nasrudin2468/free-motion/Notes/interface pinning.png

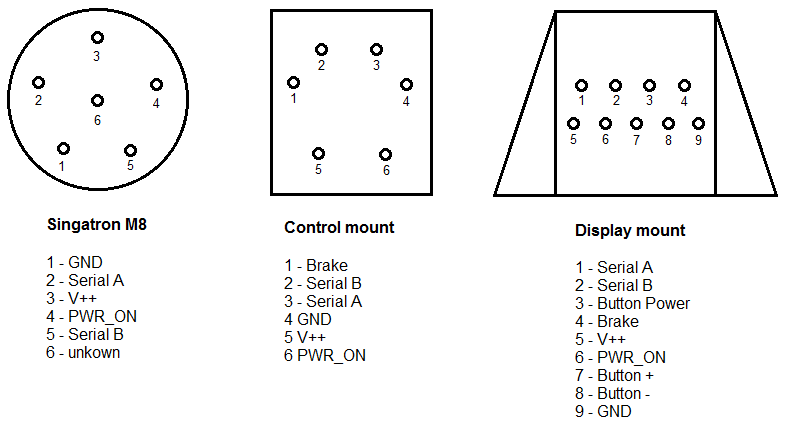
Notes/interface pinning.png
