nasrudin2468/free-motion/Notes/WD BH-EVO Controller to display 2017-04-20-1.png

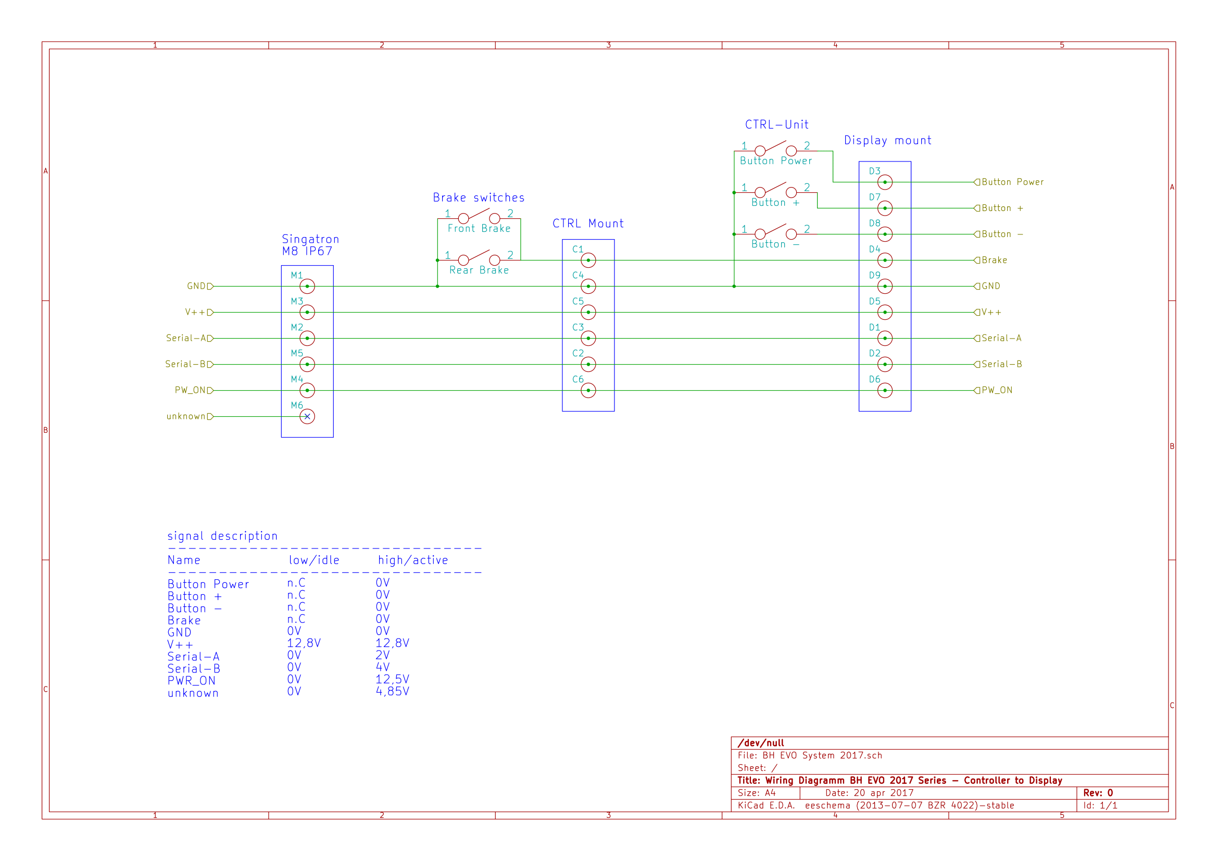
Notes/WD BH-EVO Controller to display 2017-04-20-1.png
