nasrudin2468/free-motion/PCB/REV 0.1/Documentation/3d_bot.png

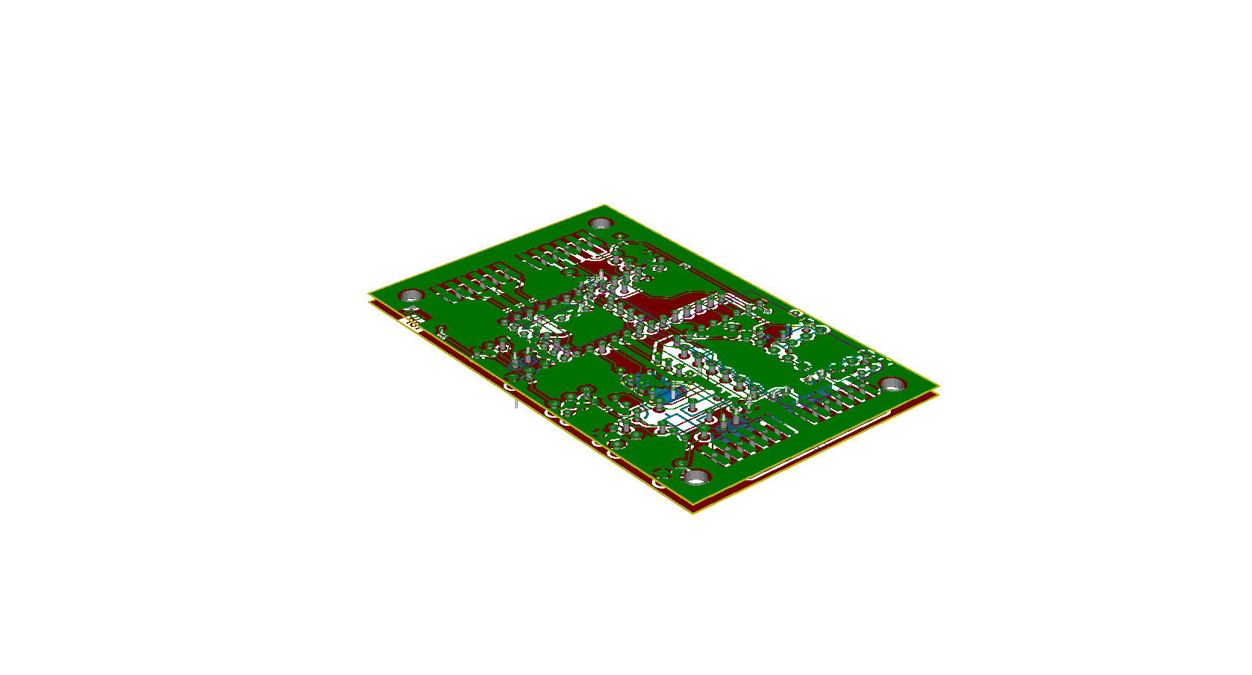
PCB/REV 0.1/Documentation/3d_bot.png
