nasrudin2468/free-motion/PCB/REV 0.1/Documentation/partlist - development - all parts.ods

ID | INDEX | count | Comment | part name | Mouser Ordner Number | Ext. Supplier | Ext. Order Number | Price per part (€) | Price (€)
1 | U1 | 1 | Teensy build: leave out if you don't need smartphone connection | BLUEFR_LE_UART_FR_BLE | 485-2479 |  |  | 14,88 | 14,88
2 | Q2 | 1 |  | LP0701N3-G | 689-LP0701N3-G |  |  | 1,4 | 1,4
3 | R3,R15 | 2 |  | 100R | MFR-25FRF52-100R |  |  | 0,085 | 0,17
4 | R13,R16,R4,R7,R9,R2,R6 | 7 |  | 1K | MFR-25FRF52-1K |  |  | 0,085 | 0,595
5 | R17 | 1 |  | 1K1 | MFR-25FRF52-1K1 |  |  | 0,085 | 0,085
6 | R8 | 1 |  | 470R | MFR-25FRF52-470R |  |  | 0,085 | 0,085
7 | R5,R11,R12 | 3 |  | 2K | MFR-25FRF52-2K |  |  | 0,085 | 0,255
8 | R10,R14 | 2 |  | 3K9 | MFR-25FRF52-3K9 |  |  | 0,085 | 0,17
9 | R1 | 1 |  | 6K8 | MFR-25FRF52-6K8 |  |  | 0,085 | 0,085
10 | K1 | 1 | Use spare from position 23. not needed for Teensy build | header 3pin | - |  |  | 0 | 0
11 | SP1 | 1 | Teensy build: leave out if you don't need acoustic feedback | CPE-165 | 490-CPE-165 |  |  | 1,01 | 1,01
12 | JP2,JP1 | 2 | Use spare from position 23 or short with solder. Must not be shorted for Teensy build. | jumper wire / header 2pin | - |  |  | 0 | 0
13 | D1 | 1 | Can be a 5V Zener, too | Std Diode / Zener 5V | TZX5V1B-TAP |  |  | 0,17 | 0,17
14 | D5,D4,D2,D3,D6 | 5 |  | ZENER 5V | TZX5V1B-TAP |  |  | 0,17 | 0,85
15 | C2,C3,C1 | 3 |  | 1uF | C333C105K5R5TA |  |  | 0,377 | 1,131
16 | Q5,Q3,Q1 | 3 |  | BC547 | 512-BC547BTA |  |  | 0,179 | 0,537
17 | Q4 | 1 |  | BC557 | 512-BC557BTA |  |  | 0,196 | 0,196
18 | P1,P2,P3,P4 | 4 | recommended but soldering cables directly on PCB is possible, too | PHOENIX1989780 | 651-1989780 |  |  | 0,655 | 2,62
19 | U2 | 1 | Teensy build: leave out if you don't need terrain based motorcontrol | SEN-13762 | 474-SEN-13762 |  |  | 12,71 | 12,71
20 | U3 | 1 |  | 78L05 | 926-LM78L05ACZ/NOPB |  |  | 0,51 | 0,51
21 | U4 | 1 |  | TEENSY_3.2 | 474-DEV-13736 |  |  | 19,87 | 19,87
22 | Outl | 1 |  | EuroBoard 80mmX50mm | - | oshpark.com |  | 5 | 5
23 | - | 2 | Use for all modules | Header | M20-9992545 |  |  | 0,731 | 1,462
24 | - | 1 | Bus-connector external female 6 pol | Phoenix 1522192 | 651-1522192 |  |  | 19,96 | 19,96
25 | - | 1 | Bus-connector external male 6 pol | Phoenix 1522095 | 651-1522095 |  |  | 17,33 | 17,33
26 | - | 1 | Bus-connector internal male 6 pol - can replace pos.23 for BH2017 series | 06T-JWPF-VSLE-D | - | rs-online.com | 820-1282 | 22,66 | 22,66
27 | - | 1 | Bus-connector internal female 6 pol - can replace pos.24 for BH2017 series | 06R-JWPF-VSLE-D | - | rs-online.com | 820-1289 | 14,43 | 14,43
28 | - | 1 | Crimp Contacts male for pos.26 | 01SWPTSWPT-24L-150 | - | rs-online.com | 820-1298 | 5,91 | 5,91
29 | - | 1 | Crimp Contacts female for pos.27 | 01SWPRSWPR-24L-150 | - | rs-online.com | 820-1286 | 5,91 | 5,91
30 | - | 1 | leave out if you don't need automatic light switch | SFH 3310 | 720-SFH3310 |  |  | 0,774 | 0,774
31 | - | 1 |  | Enclosure | 546-1591XXBSBK |  |  | 5,28 | 5,28
32 |  | 1 |  | jumper wire | 932-MIKROE-511 |  |  | 2,55 | 2,55
33 |  | 1 |  | CH340G USB to Serial (TTL) Module/Adapter | 713-317990026 |  |  | 1,66 | 1,66
 |  |  |  |  |  |  |  |  | 160,255
