nasrudin2468/free-motion/Notes/protocol analysis 2017-08-06.ods

Sheet: COM33_2017-05-01 HEX
 |  |  |  |  |  |  |  |  |  |  |  |  |  | Comments COM 33 (Serial A) begin Log
0 | FD | 7F | 0F |  |  |  |  |  |  |  |  |  |  | unknown (probably false reading due switching condition)
40 | 30 | 31 | 50 | 35 | 39 | 35 | 44 | 0D
40 | 30 | 31 | 50 | 35 | 39 | 35 | 44 | 0D
40 | 30 | 31 | 43 | 30 | 32 | 30 | 30 | 30 | 30 | 30 | 37 | 30 | 0D
40 | 30 | 31 | 43 | 30 | 32 | 30 | 30 | 30 | 30 | 30 | 37 | 30 | 0D
40 | 30 | 31 | 43 | 30 | 32 | 30 | 30 | 30 | 30 | 30 | 37 | 30 | 0D
40 | 30 | 31 | 43 | 30 | 32 | 30 | 30 | 30 | 30 | 30 | 37 | 30 | 0D
40 | 30 | 31 | 43 | 30 | 32 | 30 | 30 | 30 | 30 | 30 | 37 | 30 | 0D
40 | 30 | 31 | 43 | 30 | 32 | 30 | 30 | 30 | 30 | 30 | 37 | 30 | 0D
40 | 30 | 31 | 43 | 30 | 32 | 30 | 30 | 30 | 30 | 30 | 37 | 30 | 0D
40 | 30 | 31 | 43 | 30 | 32 | 30 | 30 | 30 | 30 | 30 | 37 | 30 | 0D
40 | 30 | 31 | 43 | 30 | 32 | 30 | 30 | 30 | 30 | 30 | 37 | 30 | 0D
40 | 30 | 31 | 43 | 30 | 32 | 30 | 30 | 30 | 30 | 30 | 37 | 30 | 0D
40 | 30 | 31 | 43 | 30 | 32 | 30 | 30 | 30 | 30 | 30 | 37 | 30 | 0D
40 | 30 | 31 | 42 | 4F | 46 | 46 | 30 | 30 | 30 | 30 | 30 | 43 | 0D
40 | 30 | 31 | 42 | 4F | 46 | 46 | 30 | 30 | 30 | 30 | 30 | 43 | 0D
0 | 8D | 46 | 46 | FA |  |  |  |  |  |  |  |  |  | unknown (probably false reading due switching condition)
40 | 30 | 31 | 50 | 35 | 39 | 35 | 44 | 0D |  |  |  |  |  | Lights on / off
40 | 30 | 31 | 50 | 35 | 39 | 35 | 44 | 0D
40 | 30 | 31 | 43 | 30 | 32 | 30 | 30 | 30 | 30 | 30 | 37 | 30 | 0D
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
40 | 30 | 31 | 43 | 30 | 30 | 30 | 30 | 30 | 30 | 30 | 37 | 32 | 0D
40 | 30 | 31 | 43 | 30 | 30 | 30 | 30 | 30 | 30 | 30 | 37 | 32 | 0D
40 | 30 | 31 | 43 | 30 | 30 | 30 | 30 | 30 | 30 | 30 | 37 | 32 | 0D
40 | 30 | 31 | 43 | 30 | 30 | 30 | 30 | 30 | 30 | 30 | 37 | 32 | 0D

Sheet: protocol spec - controller
boot sequence – 12 Bytes
 | Nr. | Type | value HEX | value ASCII | comment | refer to APK source file
 | 0 | static | 0x40 | @ | Header Byte– Identifies beginning of a new message and triggers software parser
 | 1 | static | 0x30 | 0 | Adress Byte – seems alway to be 0
 | 2 | static | 0x31 | 1 | Adress Byte – seems alway to be 1
 | 3 | dynamic | 0x50 | P | Adress Byte – changes in different modes. P = Program?
 | 4 | static | 0x35 | 5 | unknown
 | 5 | static | 0x39 | 9 | unknown
 | 6 | static | 0x30 | 0-1 | unknown
 | 7 | static | 0x30 | 0-1 | unknown
 | 8 | static | 0x30 | 0-1 | unknown
 | 9 | dynamic | 0x30-39, 40-46 | 0-9, A-F | Bytewise XOR checksum over adress and payload bytes. Holds upper 4 bits of result in ASCII
 | 10 | dynamic | 0x30-39, 40-46 | 0-9, A-F | Bytewise XOR checksum over adress and payload bytes. Holds lower 4 bits of result in ASCII
 | 11 | static | 0x0D | \n | Last Byte – end of a message (unix: New line)
operation modus – 31 Bytes
 | Nr. | Type | value HEX | value ASCII | comment | refer to APK source file
 | 0 | static | 0x40 | @ | Header Byte– Identifies beginning of a new message and triggers software parser
 | 1 | static | 0x30 | 0 | Adress Byte – seems alway to be 0
 | 2 | static | 0x31 | 1 | Adress Byte – seems alway to be 1
 | 3 | dynamic | 0x43 | D | Adress Byte – changes in different modes. D = Display (target)?
 | 4 | static | 0x30 | 0 | APK Source: UINT8_2 Battery Voltage: =UINT8 * 0,2647059 * PI
 | 5 | dynamic | 0x30, 32 | 0,2 | APK Source: UINT8_1 Battery Voltage: =UINT8 * 0,2647059 * PI
 | 6 | dynamic | 0x30, 36 | 0,6 | APK Source: UINT8_0 Battery Voltage: =UINT8 * 0,2647059 * PI
 | 7 | static | 0x30 | 0 | APK Source: UINT8_2 Battery Current: =UINT8 * 0,6033183* PI
 | 8 | dynamic | 0x30, 31 | 0,1 | APK Source: UINT8_1 Battery Current: =UINT8 * 0,6033183* PI
 | 9 | dynamic | 0x30-32, 36 | 0-2,6 | APK Source: UINT8_0 Battery Current: =UINT8 * 0,6033183* PI
 | 10 | dynamic | 0x37 | 0-4, 6, 7 | power mode – off:0 eco:1 normal:2 sport:3 turbo:4 autorun(6km/h):6 brakes:7 APK Source: StatusCode1
 | 11 | static | 0x30 | 0 | APK Source: UINT8_1 StatusCode2
 | 12 | static | 0x30 | 0 | APK Source: UINT8_0 StatusCode2
 | 13 | static | 0x30 | 0 | APK Source: UINT8_2 Speed: = 36 * (wheelsize_mm / 12) * (UINT8 / 10000)
 | 14 | dynamic | 0x30-36 | 0-6 | APK Source: UINT8_1 Speed: = 36 * (wheelsize_mm / 12) * (UINT8 / 10000)
 | 15 | dynamic | 0x30-39, | 0-9 | APK Source: UINT8_0 Speed: = 36 * (wheelsize_mm / 12) * (UINT8 / 10000)
 | 16 | static | 0x30 | 0 | unknown
 | 17 | static | 0x31 | 1 | unknown
 | 18 | dynamic | 0x31-37 | 1-7 | increases over log time – battery capacity / voltage?
 | 19 | dynamic | 0x30-31 | 0,1 | increases when force applied on pedal. Torque signal?
 | 20 | dynamic | 0x35-39 | 5-9 | increases when force applied on pedal. Torque signal?
 | 21 | dynamic | 0x30-39 | 0-9 | increases when force applied on pedal. Torque signal?
 | 22 | static | 0x30 | 0 | unknown
 | 23 | dynamic |  |  | Initially 0. changes when force is applied on pedal, stays unequal 0 until reboot
 | 24 | dynamic |  |  | Initially 0. changes when force is applied on pedal, stays unequal 0 until reboot
 | 25 | dynamic |  |  | Initially 0. changes when force is applied on pedal
 | 26 | dynamic |  |  | Initially 0. changes when force is applied on pedal
 | 27 | dynamic |  |  | Initially 0. changes when force is applied on pedal
 | 28 | dynamic | 0x30-39, 40-46 | 0-9, A-F | Bytewise XOR checksum over adress and payload bytes. Holds upper 4 bits of result in ASCII
 | 29 | dynamic | 0x30-39, 40-46 | 0-9, A-F | Bytewise XOR checksum over adress and payload bytes. Holds lower 4 bits of result in ASCII
 | 30 | static | 0x0D | \n | Last Byte – end of a message (unix: New line) | temperature?????
Read P59
 | 0 | static | 0x40 | @ | Header Byte– Identifies beginning of a new message and triggers software parser
 | 1 | static | 0x30 | 0 | Adress Byte – seems alway to be 0
 | 2 | static | 0x31 | 1 | Adress Byte – seems alway to be 1
 | 3 | dynamic |  | P | Adress Byte – P Paramter?
 | 4 | static |  | 5 | Parameter Number UINT8_1
 | 5 | static |  | 9 | Parameter Number UINT8_0
 | 6 |  |  | 0 | unknown
 | 7 |  |  | 3 | Software Version of controller – major value
 | 8 |  |  | 6 | Software Version of controller – minor value
 | 9 | dynamic | 0x30-39, 40-46 | 0-9, A-F | Bytewise XOR checksum over adress and payload bytes. Holds upper 4 bits of result in ASCII
 | 10 | dynamic | 0x30-39, 40-46 | 0-9, A-F | Bytewise XOR checksum over adress and payload bytes. Holds lower 4 bits of result in ASCII
 | 11 | static | 0x0D | \n | Last Byte – end of a message (unix: New line)
Read P00
 | 0 | static | 0x40 | @ | Header Byte– Identifies beginning of a new message and triggers software parser
 | 1 | static | 0x30 | 0 | Adress Byte – seems alway to be 0
 | 2 | static | 0x31 | 1 | Adress Byte – seems alway to be 1
 | 3 | dynamic |  | P | Adress Byte – P Paramter?
 | 4 | static |  | 5 | Parameter Number UINT8_1
 | 5 | static |  | 9 | Parameter Number UINT8_0
 | 6 | static |  | 0 | Software Version of controller – unused
 | 7 | static |  | 3 | Software Version of controller – major value
 | 8 | static |  | 7 | Software Version of controller – minor value
 | 9 | dynamic | 0x30-39, 40-46 | 0-9, A-F | Bytewise XOR checksum over adress and payload bytes. Holds upper 4 bits of result in ASCII
 | 10 | dynamic | 0x30-39, 40-46 | 0-9, A-F | Bytewise XOR checksum over adress and payload bytes. Holds lower 4 bits of result in ASCII
 | 11 | static | 0x0D | \n | Last Byte – end of a message (unix: New line)
save program 8 Bytes |  |  |  |  |  | refer to APK source file
 | 0 | static | 0x40 | @ | Header Byte– Identifies beginning of a new message and triggers software parser
 | 1 | static | 0x30 | 0 | Adress Byte – seems alway to be 0
 | 2 | static | 0x31 | 1 | Adress Byte – seems alway to be 1
 | 3 | dynamic | 0x43 | O | O from String „OK“ - ACK for changed parameters?
 | 4 | static | 0x30 | K | K from String „OK“ - ACK for changed parameters?
 | 5 | static | 0x30-39, 40-46 | 0-9, A-F | Bytewise XOR checksum over adress and payload bytes. Holds upper 4 bits of result in ASCII
 | 6 | static | 0x30-39, 40-46 | 0-9, A-F | Bytewise XOR checksum over adress and payload bytes. Holds lower 4 bits of result in ASCII
 | 7 | static | 0x0D | \n | Last Byte – end of a message (unix: New line)

Sheet: parameter specification
P-variables | name | Type | Writable | default | 16-06-17-a | default | Description
 | P00 | static | NO | 036 | 036 | 036 | program version of controller (/10)
 | P01 | static | Yes | 208 | 208 | 208 | EBS Voltlimit
 | P02 |  |  | 136 | 136 | 136 | Green Lamp
 | P03 |  |  | 134 | 134 | 134 | Amber Lamp
 | P04 |  |  | 128 | 128 | 128 | Red Lamp
 | P05 |  |  | 117 | 117 | 117 | Flash Lamp
 | P06 |  |  | 002 | 002 | 002 | ProtectVolt
 | P07 | dynamic | Yes | 027 | 027 | 027 | Wheelsize – 27 is 27.5 Zoll (18,20,22,24,26,27,28)
 | P08 | static | Yes | 040 | 040 | 040 | NMS Speed Limit
 | P09 |  |  | 000 | 000 | 000 | BST Speed Limit
 | P10 |  |  | 087 | 087 | 087 | Static Current Hi (*255/5)
 | P11 |  |  | 031 | 031 | 031 | Static Current Lo (*255/5)
 | P12 |  |  | 108 | 108 | 108 | Aver Current (*0,005*6,5*208)
 | P13 | static | Yes | 058 | 058 | 058 | Peak Current (*0,005*6,5*255/5)
 | P14 |  |  | 005 | 005 | 005 | EBS Charg Limit (*0,005*6,5*208)
 | P15 |  |  | 004 | 004 | 004 | Slip Charg limit (*0,005*6,5*255/5)
 | P16 |  |  | 255 | 255 | 255 | TMM Limit Hi (*255/5)
 | P17 |  |  | 015 | 015 | 015 | TMM Limit Lo (*255/5)
 | P18 |  |  | 061 | 061 | 061 | TMM Base (*255/5)
 | P19 |  |  | 001 | 001 | 001 | TMM Resp Spd (*255/5)
 | P20 |  |  | 005 | 005 | 005 | TMM Continued (*255/5)
 | P21 |  |  | 060 | 060 | 060 | TMM Amplification (*10)
 | P22 | static | Yes | 000 | 000 | 000 | TMM En Speed (SpeedToCount)
 | P23 |  |  | 004 | 004 | 004 | TMM Threshold
 | P24 |  |  | 040 | 040 | 040 | SpeedRange (*10)
 | P25 |  |  | 001 | 001 | 001 | Phase Angel (selectedIndex) (60, 120, 180)
 | P26 |  |  | 075 | 075 | 075 | Templimit (65,70,75,80,86,90,100,105)
 | P27 |  |  | 000 | 000 | 000 | Brake Mode
 | P28 |  |  | 024 | 024 | 024 | Motor Magnets (10,12,14,16)
 | P29 |  |  | 002 | 002 | 002 | Move Speed (SelectedIndex) 3.0, 4.5, 6.0)
 | P30 |  |  | 000 | 000 | 000 | MotorLimit (SelectedIndex) disable, enable
 | P31 |  |  | 015 | 015 | 015 | ECO PWM1
 | P32 |  |  | 020 | 020 | 020 | ECO PWM2
 | P33 | dynamic |  | 030 | 033 | 030 | ECO PWM3
 | P34 |  |  | 022 | 022 | 022 | ECO Speed1 (SpeedToCount)
 | P35 |  |  | 030 | 030 | 030 | ECO Speed2 (SpeedToCount)
 | P36 | static | Yes | 047 | 047 | 047 | ECO Current (*0,005*6,5*208)
 | P37 |  |  | 030 | 030 | 030 | STD PWM1
 | P38 |  |  | 035 | 035 | 035 | STD PWM2
 | P39 |  |  | 045 | 045 | 045 | STD PWM3
 | P40 |  |  | 022 | 022 | 022 | STD Speed1 (SpeedToCount)
 | P41 |  |  | 030 | 030 | 030 | STD Speed2 (SpeedToCount)
 | P42 | static | Yes | 074 | 074 | 074 | STD Current (*0,005*6,5*208)
 | P43 |  |  | 065 | 065 | 065 | Sport PWM1
 | P44 |  |  | 075 | 075 | 075 | Sport PWM2
 | P45 |  |  | 085 | 085 | 085 | Sport PWM3
 | P46 |  |  | 022 | 022 | 022 | Sport Speed1 (SpeedToCount)
 | P47 |  |  | 030 | 030 | 030 | Sport Speed2 (SpeedToCount)
 | P48 | static | Yes | 088 | 088 | 088 | Sport Current (*0,005*6,5*208)
 | P49 |  |  | 080 | 080 | 080 | Borst PWM1
 | P50 |  |  | 090 | 090 | 090 | Borst PWM2
 | P51 |  |  | 100 | 100 | 100 | Borst PWM3
 | P52 |  |  | 022 | 022 | 022 | Borst Speed1 (SpeedToCount)
 | P53 |  |  | 030 | 030 | 030 | Borst Speed2 (SpeedToCount)
 | P54 | static | Yes | 101 | 101 | 101 | Borst Current (*0,005*6,5*208)
 | P55 | static | Yes | 000 | 000 | 000 | ECO Current2 (*0,005*6,5*208)
 | P56 | static | Yes | 000 | 000 | 000 | STD Current2 (*0,005*6,5*208)
 | P57 | static | Yes | 000 | 000 | 000 | Sport Current2 (*0,005*6,5*208)
 | P58 | static | Yes | 000 | 000 | 000 | Borst Current2 (*0,005*6,5*208)
 | P59 | dynamic |  | 037 | 037 | 037 | AhSOH value
 | P60 |  |  | 000 | 000 | 000 | unknown
 | P61 |  |  | 000 | 000 | 000 | unknown
 | P62 |  |  | 000 | 000 | 000 | unknown
 | P63 | static | NO | EVO_EU.. | EVO_EU.. | EVO_EU.. | unknown
 | P64 |  |  | 011 | 016 | 016 | unknown
 | P65 |  |  | 064 | 064 | 064 | unknown
 | P66 |  |  | 048 | 048 | 048 | unknown
 | P67 | dynamic | NO | 002 | 049 | 049 | unknown
 | P68 |  |  | 080 | 080 | 080 | unknown
 | P69 |  |  | 054 | 054 | 054 | unknown
 | P70 |  |  | 057 | 057 | 057 | unknown
 | P71 |  |  | 027 | 048 | 048 | unknown
 | P72 | dynamic | NO | 027 | 052 | 052 | unknown
 | P73 | dynamic | NO | 055 | 050 | 050 | unknown
 | P74 |  | NO | 054 | 054 | 054 | unknown
 | P75 |  | NO | 051 | 051 | 051 | unknown
 | P76 |  |  | 085 | 085 | 085 | unknown
 | P77 |  |  | 046 | 046 | 046 | unknown
 | P78 |  |  | 046 | 046 | 046 | unknown
 | P79 |  |  | 052 | 052 | 052 | unknown
 | P80 | dynamic | NO | 055 | 048 | 055 | unknown
 | P81 |  |  | 048 | 048 | 048 | unknown
 | P82 |  |  | 050 | 050 | 050 | unknown
 | P83 | dynamic | NO | 053 | 054 | 057 | unknown
 | P84 |  |  | 048 | 048 | 048 | unknown
 | P85 |  | NO | 053 | 053 | 053 | unknown
 | P86 | dynamic | NO | 040 | 050 | 049 | unknown
 | P87 | dynamic | NO | 040 | 048 | 048 | unknown
 | P88 | dynamic | NO | 048 | 053 | 053 | unknown
 | P89 | dynamic | NO | 048 | 057 | 057 | unknown
 | P90 |  |  | 048 | 048 | 048 | unknown
 | P91 |  |  | 048 | 048 | 048 | unknown
 | P92 |  |  | 048 | 048 | 048 | unknown
 | P93 |  | NO | 052 | 052 | 052 | unknown
 | P94 | dynamic | NO | 067 | 069 | 048 | unknown
 | P95 |  |  | 063 | 063 | 055 | unknown
 | P96 |  |  | 000 | 000 | 000 | unknown
 | P97 | dynamic | NO | 027 | 026 | 029 | unknown
 | P98 | dynamic | NO | 027 | 026 | 029 | unknown
 | P99 |  |  | 003 | 003 | 003 | unknown
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
