nasrudin2468/free-motion/PCB/REV 0.1/Documentation/circuit diagram.pdf

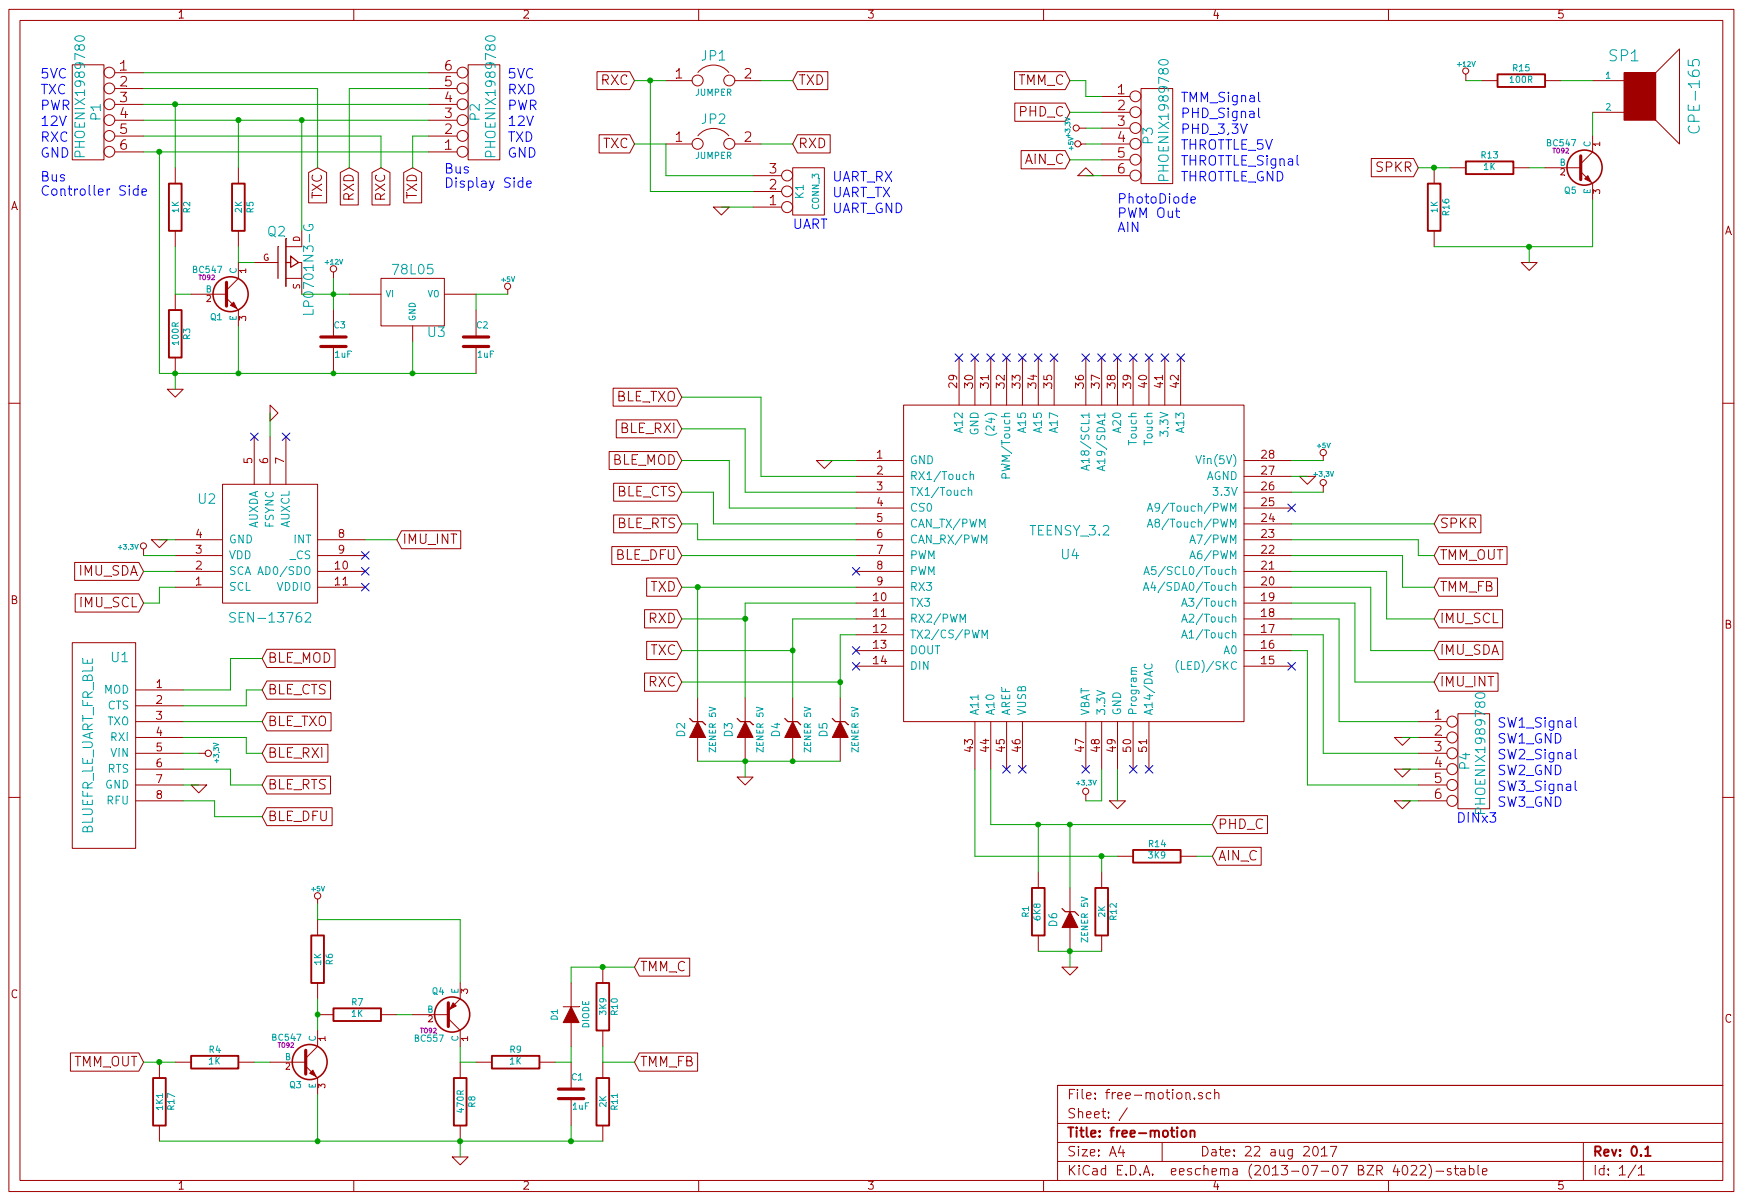
[picture p5: page 1]
