nasrudin2468/free-motion/PCB/REV 0.1/Documentation/pcb layout zoomed.pdf

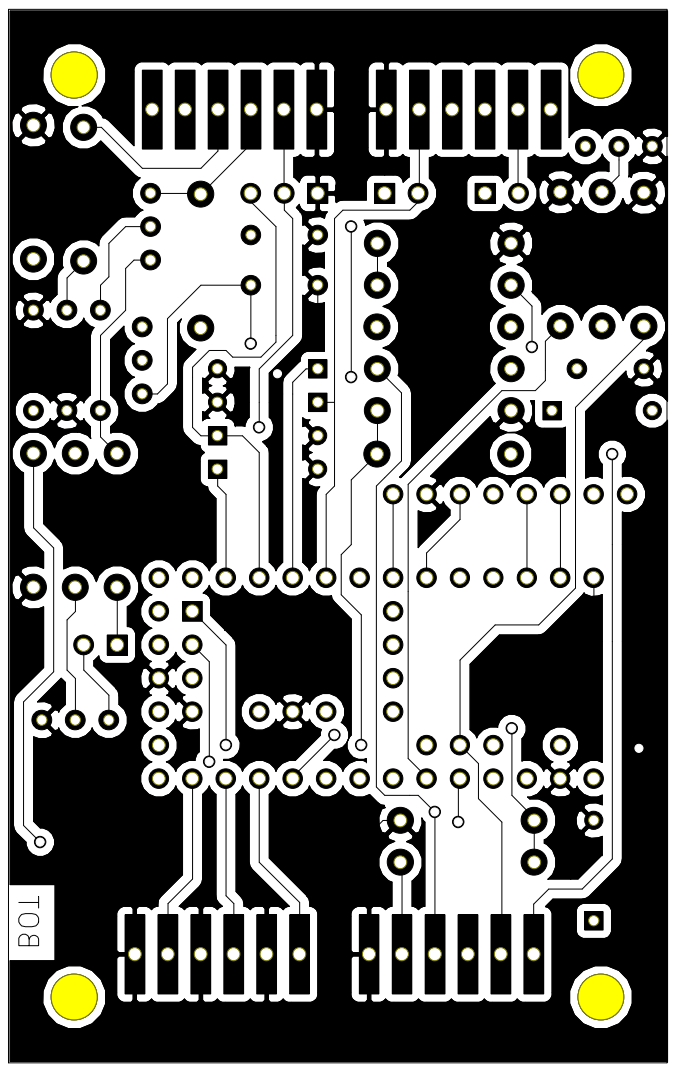
[picture p6: page 1]

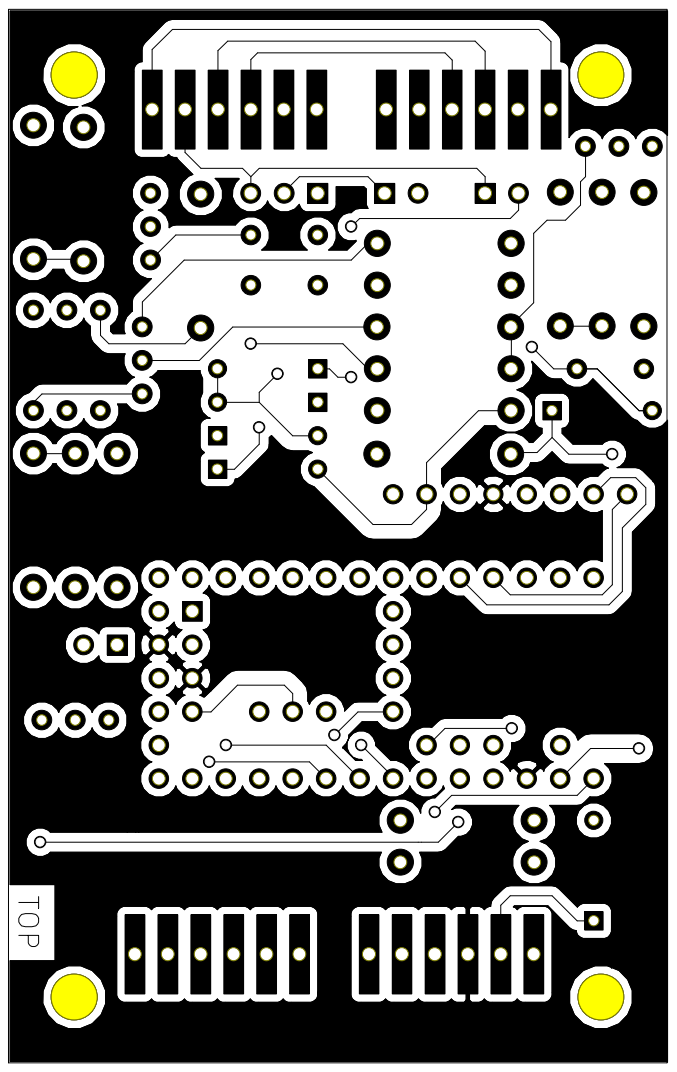
[picture p7: page 2]

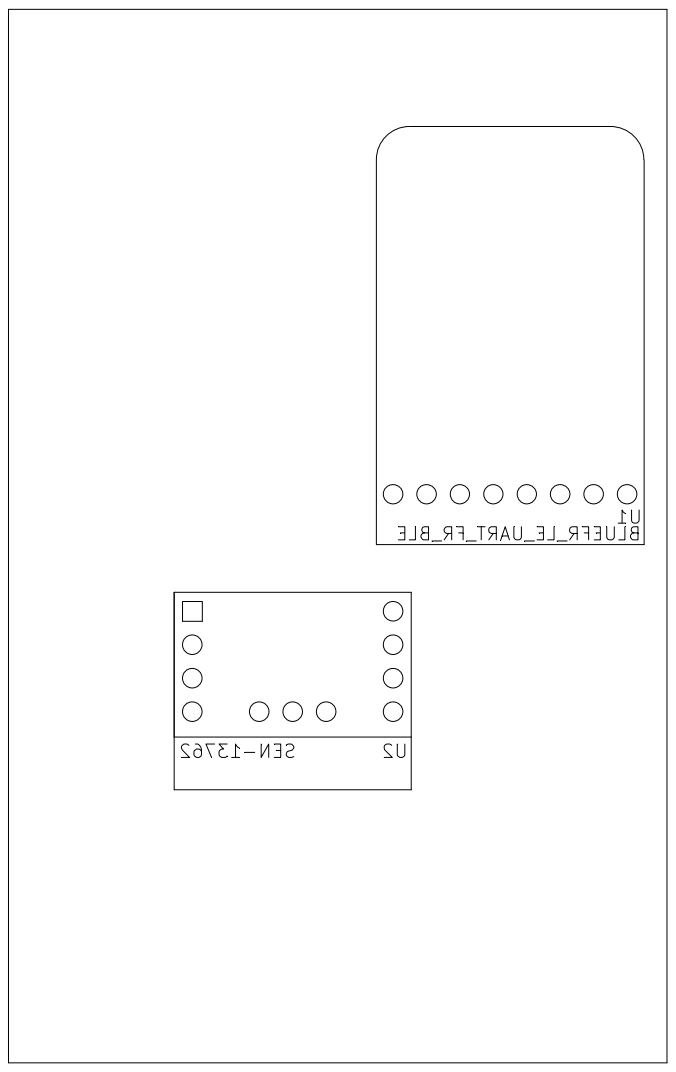
[picture p8: page 3]

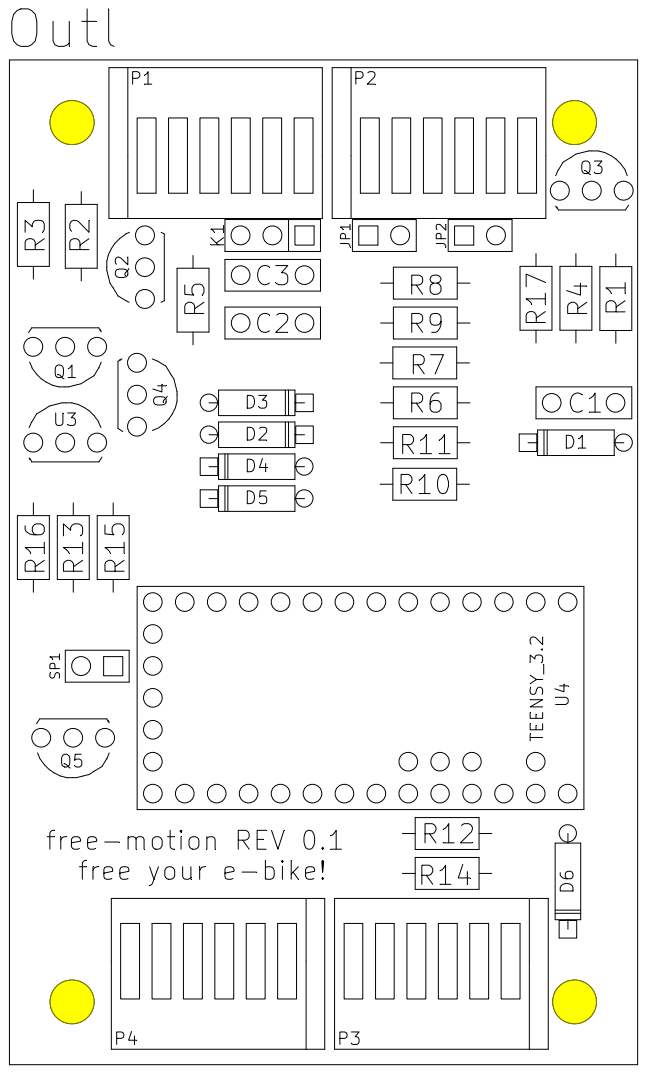
[picture p9: page 4]
