nasrudin2468/free-motion/PCB/REV 0.1/free-motion.kicad_pcb

## KiCad design PCB/REV 0.1/free-motion.kicad_pcb (2017-08-22)

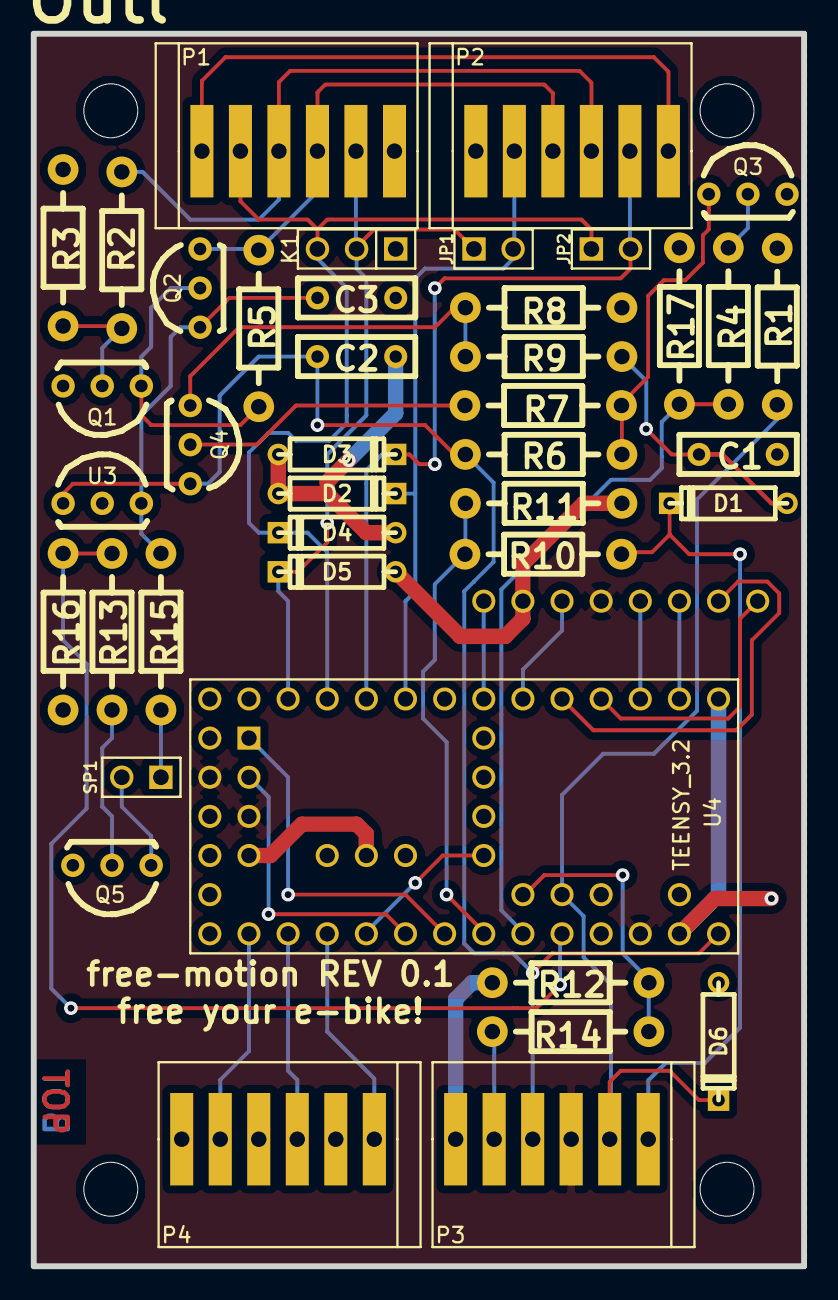
[picture p10: board free-motion.kicad_pcb from above]

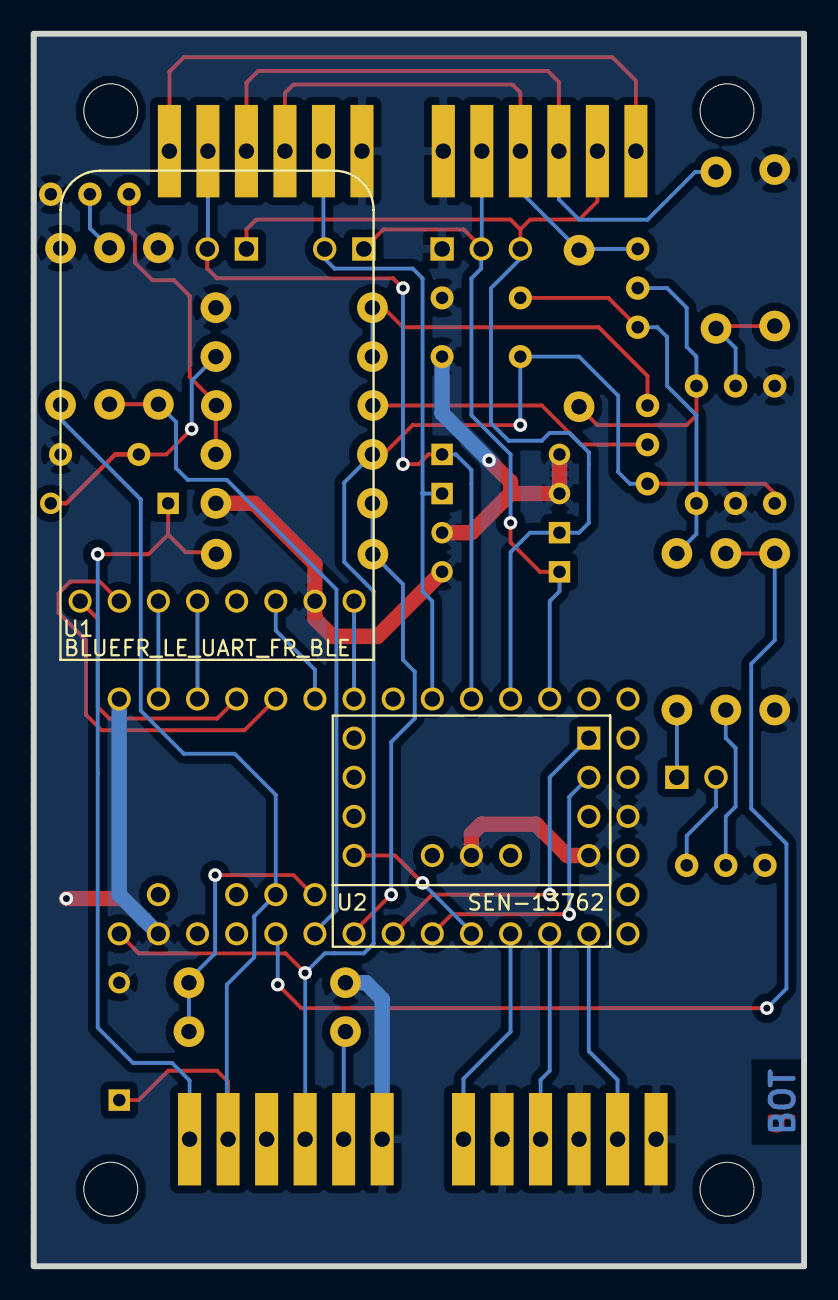
[picture p11: board free-motion.kicad_pcb from below]

Board: 2 copper layers, 50.0 x 80.0 mm, 44 parts (2 on the bottom side), 40 nets.

Parts:
C1, C2, C3: 1uF; Capacitor7x2.5RM5
D1: DIODE; D3
D2, D3, D4, D5, D6: ZENER 5V; D3
JP1, JP2: JUMPER; PIN_ARRAY_2X1
K1: CONN_3; PIN_ARRAY_3X1
Outl: EuroBoard_viertel_Type-I_80mmX50mm_holes
P1, P2, P3, P4: PHOENIX1989780; Phoenix_PTFSA_0.5
Q1, Q3, Q5: BC547; TO-92-Free-inline-wide
Q2: LP0701N3-G; TO-92-FET-inline-wide-SGD
Q4: BC557; TO-92-Free-inline-wide
R1: 6K8; Resistor_Horizontal_RM10mm_22Apr2011
R2, R4, R6, R7, R9, R13, R16: 1K; Resistor_Horizontal_RM10mm_22Apr2011
R3, R15: 100R; Resistor_Horizontal_RM10mm_22Apr2011
R5, R11, R12: 2K; Resistor_Horizontal_RM10mm_22Apr2011
R8: 470R; Resistor_Horizontal_RM10mm_22Apr2011
R10, R14: 3K9; Resistor_Horizontal_RM10mm_22Apr2011
R17: 1K1; Resistor_Horizontal_RM10mm_22Apr2011
SP1: CPE-165; PIN_ARRAY_2X1
U1: BLUEFR_LE_UART_FR_BLE; Bluefruit_LE_UART
U2: SEN-13762
U3: 78L05; TO-92-LM78L05
U4: TEENSY_3.2; TEENSY3.2

Connections:
+3.3V: P3.3, U1.5, U2.3, U4.26, U4.48
+5V: C2.1, P3.4, Q4.3, R6.1, U3.VO, U4.28
+12V: C3.1, Q2.S, R15.1, U3.VI
AIN_C: P3.5, R14.2
BLE_CTS: U1.2, U4.5
BLE_DFU: U1.8, U4.7
BLE_MOD: U1.1, U4.4
BLE_RTS: U1.6, U4.6
BLE_RXI: U1.4, U4.3
BLE_TXO: U1.3, U4.2
GND: C1.2, C2.2, C3.2, D2.1, D3.1, D4.1, D5.1, D6.1, K1.1, P1.6, P2.1, P3.6, P4.2, P4.4, P4.6, Q1.3, Q3.3, Q5.3, R1.1, R3.2, R8.2, R11.2, R12.2, R16.2, R17.2, U1.7, U2.4, U2.6, U3.GND, U4.1, U4.27, U4.49
IMU_INT: U2.8, U4.19
IMU_SCL: U2.1, U4.21
IMU_SDA: U2.2, U4.20
unnamed: P1.1, P2.6
unnamed: Q5.1, SP1.2
unnamed: Q1.2, R2.2, R3.1
unnamed: P1.3, P2.4, R2.1
unnamed: P1.4, P2.3, Q2.D, R5.1
unnamed: Q1.1, Q2.G, R5.2
unnamed: Q5.2, R13.2
unnamed: R12.1, R14.1, U4.43
unnamed: C1.1, D1.1, R9.2
unnamed: Q4.2, R7.2
unnamed: Q3.2, R4.2
unnamed: P4.5, U4.16
unnamed: Q4.1, R8.1, R9.1
unnamed: R15.2, SP1.1
unnamed: P4.1, U4.18
unnamed: P4.3, U4.17
unnamed: Q3.1, R6.2, R7.1
PHD_C: D6.2, P3.2, R1.2, U4.44
RXC: D5.2, JP1.1, K1.2, P1.5, U4.12
RXD: D3.2, JP2.2, P2.5, U4.10
SPKR: R13.1, R16.1, U4.24
TMM_C: D1.2, P3.1, R10.1
TMM_FB: R10.2, R11.1, U4.22
TMM_OUT: R4.1, R17.1, U4.23
TXC: D4.2, JP2.1, K1.3, P1.2, U4.11
TXD: D2.2, JP1.2, P2.2, U4.9
