nasrudin2468/free-motion/(commit log)

2017-08-03 Initial commit. contains main notes from protocol analysis, partlist for prototype and latest code of the python tool
    [Partlist.ods, protocol analysis 2017-05-31.xlsx, pye-motion.cfg]
2017-08-21 folder restructured. - /software/pye-motion deleted - has now own repository: "pye-motion" - /documents deleted - Partslist moved
    [Partlist.ods, pye-motion.cfg]
2017-08-22 Initial circuit / PCB design REV 0.1 - circuit diagram created - pcb created - partlists created - /Notes/protocol analysis: latest findings included
    [Partlist.ods, free-motion - all parts.ods, free-motion - simple build.ods, free-motion - teensy build.ods, free-motion.csv, free-motion.kicad_pcb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]
2017-08-23 - derived missing gerberfiles, deleted double partlists
    [free-motion - simple build.ods, free-motion - teensy build.ods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]
2017-08-23 - removed unused label, rederived all gerberfiles
    [free-motion-B_Cu.gbl, free-motion-B_Mask.gbs, free-motion-B_Paste.gbp, free-motion-B_SilkS.gbo, free-motion-Cmts_User.gbr, free-motion-Dwgs_User.gbr, free-motion-Eco1_User.gbr, free-motion-Eco2_User.gbr]
2017-10-07 Add readme file containing known PCB errors of REV0.1
